ThomasVDD/SmartSupplyMini/PCB/Front.JPG

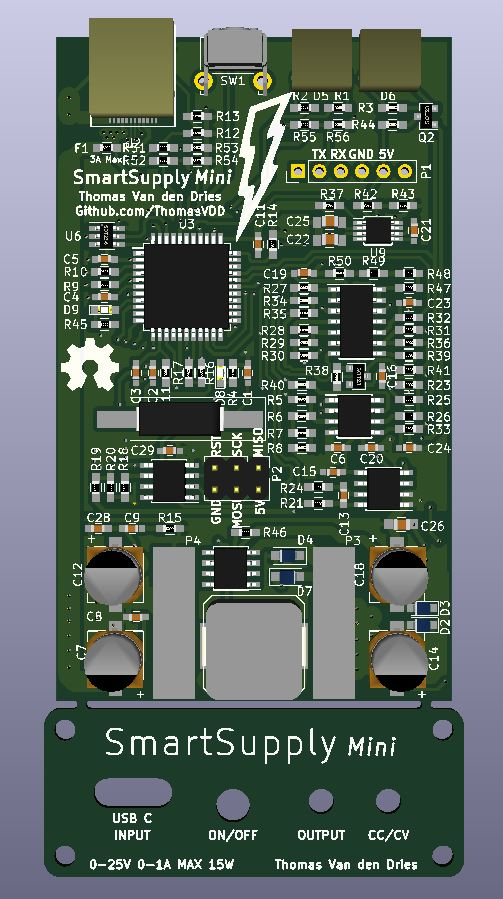
PCB/Front.JPG
