ThomasVDD/SmartSupplyMini/PCB/Back.JPG

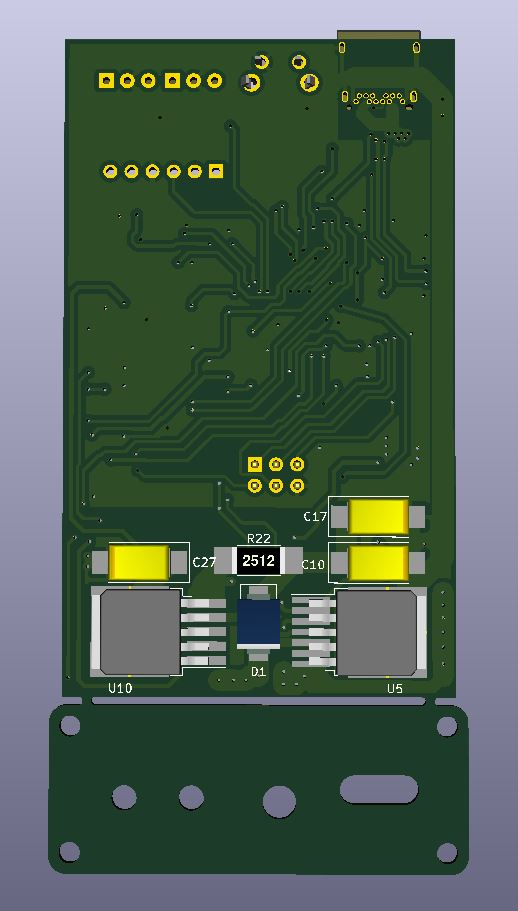
PCB/Back.JPG
