ThomasVDD/SmartSupplyMini/AndroidApp/AppImage.png

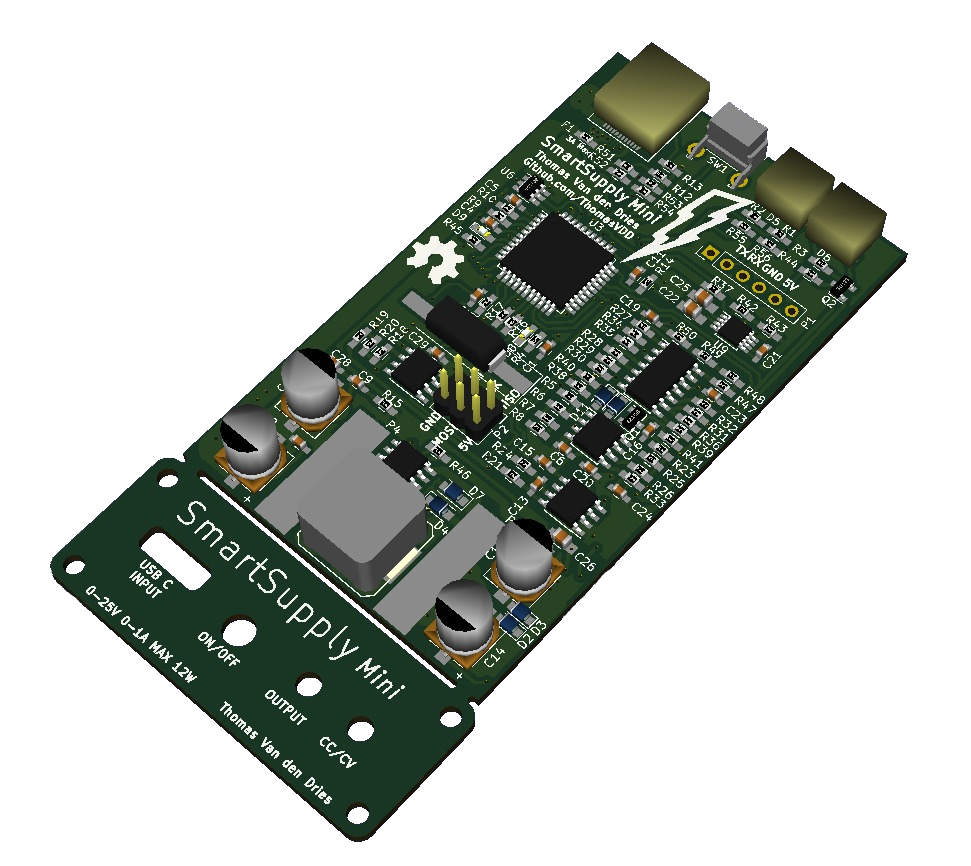
AndroidApp/AppImage.png
