ThomasVDD/SmartSupplyMini/PCB/bom.xlsx

Reference | Amount | Value | Footprint | Price/unit | Price total
Capacitors
C3, 4, 5, 6, 8, 11, 13, 15 16, 19, 20, 23, 24, 29 | 14 | 100n | Capacitors_SMD:C_0603_HandSoldering |  | 0
C22, 25, 26 | 3 | 22u | Capacitors_SMD:C_0805_HandSoldering |  | 0
C1, 2 | 2 | 22p | Capacitors_SMD:C_0603_HandSoldering |  | 0
C28 | 1 | 4.7n | Capacitors_SMD:C_0603_HandSoldering |  | 0
C9 | 1 | 47n | Capacitors_SMD:C_0603_HandSoldering |  | 0
C21 | 1 | 1u | Capacitors_SMD:C_0603_HandSoldering |  | 0
C7, 12, 14, 18 | 4 | 100u | Capacitors_SMD:CP_Elec_6.3x7.7 | 0.25 | 1 | x | http://be.farnell.com/panasonic-electronic-components/eeefk1v101xp/cap-alu-elec-100uf-35v-smd/dp/1850114
C10, 17, 27 | 3 | 22u | Capacitors_Tantalum_SMD:CP_Tantalum_Case-V_EIA-7343-20_Hand | 1.14 | 3.42 | x | http://be.farnell.com/vishay/293d226x9035d2te3/cap-tant-22uf-35v-case-d/dp/1754235
 |  |  |  |  | 0
Resistors |  |  |  |  | 0
 |  |  |  |  | 0
R11, 14, 19, 23, 25, 26, 32, 37, 38, 51, 52, 56 | 12 | 10k | Resistors_SMD:R_0603_HandSoldering |  | 0
R7, 8, 27, 28, 29, 31, 35, 43, 49, 50 | 10 | 3k 0.1% | Resistors_SMD:R_0603_HandSoldering | 0.209 | 2.09 | x | http://be.farnell.com/panasonic-electronic-components/era3aeb302v/res-thin-film-3k-0-1-0-1w-0603/dp/1670182
R5, 6, 30, 34, 36, 42, 47, 48 | 8 | 12k 0.1% | Resistors_SMD:R_0603_HandSoldering | 0.307 | 2.456 | x | http://be.farnell.com/panasonic-electronic-components/era3aeb123v/res-thin-film-12k-0-1-0-1w-0603/dp/1577620
R12, 13, 16, 17, 53, 54, 55 | 7 | 5k1 | Resistors_SMD:R_0603_HandSoldering |  | 0
R1, 2, 3, 4, 18, 44, 45 | 7 | 620R | Resistors_SMD:R_0603_HandSoldering |  | 0
R15, 33, 39, 40 | 4 | 1k | Resistors_SMD:R_0603_HandSoldering |  | 0
R21, 24 | 2 | 10R | Resistors_SMD:R_0603_HandSoldering |  | 0
R9, 10 | 2 | 22R | Resistors_SMD:R_0603_HandSoldering |  | 0
R41, 46 | 2 | 100R | Resistors_SMD:R_0603_HandSoldering |  | 0
R20 | 1 | 2.2k | Resistors_SMD:R_0603_HandSoldering |  | 0
R22 | 1 | 0R5 1W | Resistors_SMD:R_2512_HandSoldering | 1.12 | 1.12 | x | http://be.farnell.com/vishay/wslt2512r5000fea/res-metal-strip-0-5ohm-1-2512/dp/2420780
 |  |  |  |  | 0
Diodes |  |  |  |  | 0
 |  |  |  |  | 0
D5, 6 | 2 | Led_x2 | LEDs:LED_Rectangular_W5.0mm_H2.0mm-3pins | 0.335 | 0.67 | x | http://be.farnell.com/kingbright/l-130wdt-1egw/housing-led-w-1-led-red-green/dp/2001682
D8, 9 | 2 | LED | LEDs:LED_0603_HandSoldering | 0.0485 | 0.097 | x | http://be.farnell.com/kingbright/kpt-1608yc/led-0603-yellow-8mcd-588nm/dp/2099227
D2, 3, 10, 11 | 4 | 1N4148 | Diodes_SMD:D_SOD-323_HandSoldering | 0.0592 | 0.2368 | x | http://be.farnell.com/multicomp/1n4148ws/diode-h-speed-100v-0-15a-sod323/dp/1466524
D1 | 1 | SS34 | Diodes_SMD:D_SMB_Handsoldering | 0.472 | 0.472 | x | http://be.farnell.com/on-semiconductor-fairchild/ss34/diode-schottky-40v-3a-do-214/dp/1470970
D4 | 1 | SM4007PL-TP | Diodes_SMD:D_SOD-123F | 0.891 | 0.891 | x | http://be.farnell.com/micro-commercial-components/sm4007pl-tp/diode-stand-recov-1kv-sod-123fl/dp/2295709
D7 | 1 | DZ2W27000L | Diodes_SMD:D_SOD-123F | 0.555 | 0.555 | x | http://be.farnell.com/panasonic-electronic-components/dz2w27000l/diode-zener-1w-27-0v-mini2-f3/dp/2285380
 |  |  |  |  | 0
Other |  |  |  |  | 0
 |  |  |  |  | 0
F1 | 1 | FUSE 3A | Resistors_SMD:R_0603_HandSoldering | 0.26 | 0.26 | x | http://be.farnell.com/vishay/mfu0603ff03150p100/fuse-0603-smd-3-15a/dp/2057171
L1 | 1 | 47u | Inductors:SELF-WE-PD-XXL | 0.5 | 0.5
P1 | 1 | Bluetooth HM-10 | Pin_Headers:Pin_Header_Straight_1x06_Pitch2.54mm | 4 | 4
P2 | 1 | ISP | Pin_Headers:Pin_Header_Straight_2x03_Pitch2.54mm |  | 0
P3 | 1 | V+ | .pretty:BananaPad |  | 0
P4 | 1 | V- | .pretty:BananaPad |  | 0
Q1, 2 | 2 | IRLML0030TRPBF | TO_SOT_Packages_SMD:SOT-23 | 0.283 | 0.566 | x | http://be.farnell.com/infineon/irlml0030trpbf/mosfet-n-ch-30v-5-3a-sot23-3/dp/1791366
SW1 | 1 | SW_PUSH_SMALL_H | Buttons_Switches_ThroughHole:SW_Tactile_SKHH_Angled |  | 0
U1 | 1 | OPA2170 | Housings_SOIC:SOIC-8_3.9x4.9mm_Pitch1.27mm | 2.13 | 2.13 | x | http://be.farnell.com/texas-instruments/opa2170aid/op-amp-dual-36v-1-2mhz-8soic/dp/2144252
U10 | 1 | LT3080 | TO_SOT_Packages_SMD:TO-263-5_TabPin3 | 4.17 | 4.17 | x | http://be.farnell.com/linear-technology/lt3080eq-pbf/ldo-reg-0v-to-36v-1-1a-5d2pak/dp/2102649
U11 | 1 | LM334M | Housings_SOIC:SOIC-8_3.9x4.9mm_Pitch1.27mm | 0.874 | 0.874 | x | http://be.farnell.com/texas-instruments/lm334m-nopb/ic-adj-current-source-smd/dp/1469226
U2 | 1 | USB_TYPE_C | .pretty:USB_C_Connector | 1.55 | 1.55 | x | http://be.farnell.com/amphenol-commercial-products/12401548e4-2a-500/usb-connector-3-1-type-c-rcpt/dp/2564554
U3 | 1 | ATMEGA32U4RC-A | Housings_QFP:TQFP-44_10x10mm_Pitch0.8mm | 3.63 | 3.63 | x | http://be.farnell.com/microchip/atmega32u4-au/mcu-8bit-megaavr-16mhz-tqfp-44/dp/1748525
U4 | 1 | MCP41010 | Housings_SOIC:SOIC-8_3.9x4.9mm_Pitch1.27mm | 1.23 | 1.23 | x | http://be.farnell.com/microchip/mcp41010-i-sn/digital-pot-spi-10k-41010-soic8/dp/9758607
U5 | 1 | LT1370 | TO_SOT_Packages_SMD:TO-263-7_TabPin4 | 8.92 | 8.92 | x | http://be.farnell.com/linear-technology/lt1370hvir-pbf/switching-reg-500khz-6a-12v-7d2pak/dp/2252746
U6 | 1 | MAX6610 | TO_SOT_Packages_SMD:SOT-23-6_Handsoldering | 2.08 | 2.08 | x | http://be.farnell.com/maxim-integrated-products/max6610aut-t/voltage-reference-series-sot-23/dp/2729135
U7 | 1 | OPA4170 | Housings_SOIC:SOIC-14_3.9x8.7mm_Pitch1.27mm | 2.89 | 2.89 | x | http://be.farnell.com/texas-instruments/opa4170aidr/op-amp-quad-1-2mhz-0-4v-us-soic/dp/2769335
U8 | 1 | INA219 | Housings_SOIC:SOIC-8_3.9x4.9mm_Pitch1.27mm | 2.54 | 2.54 | x | http://be.farnell.com/texas-instruments/ina219bidr/current-power-monitor-11khz-soic/dp/2496402
U9 | 1 | MCP1252 | Housings_SSOP:MSOP-8_3x3mm_Pitch0.65mm | 1.27 | 1.27 | x | http://be.farnell.com/microchip/mcp1252-33x50i-ms/ic-charge-pump-120ma-smd-msop8/dp/1332064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
Y1 | 1 | 16Mhz | Crystals:Crystal_SMD_HC49-SD_HandSoldering | 0.301 | 0.301 | x | http://be.farnell.com/fox-electronics/foxsdlf-160-20/crystal-16-0mhz-20pf-smd/dp/2063983
 |  |  |  |  | 49.9188
 |  |  |  | BTW | 21%
 |  |  |  | Total | 60.401748
 |  |  |  | PCB | 36
 |  |  |  | Shipping | 18
 |  |  |  | Import | 25
 |  |  |  | Total | 79
 |  |  |  | Total | 99.901748
