ThomasVDD/SmartSupplyMini/PCB/Schematic.pdf

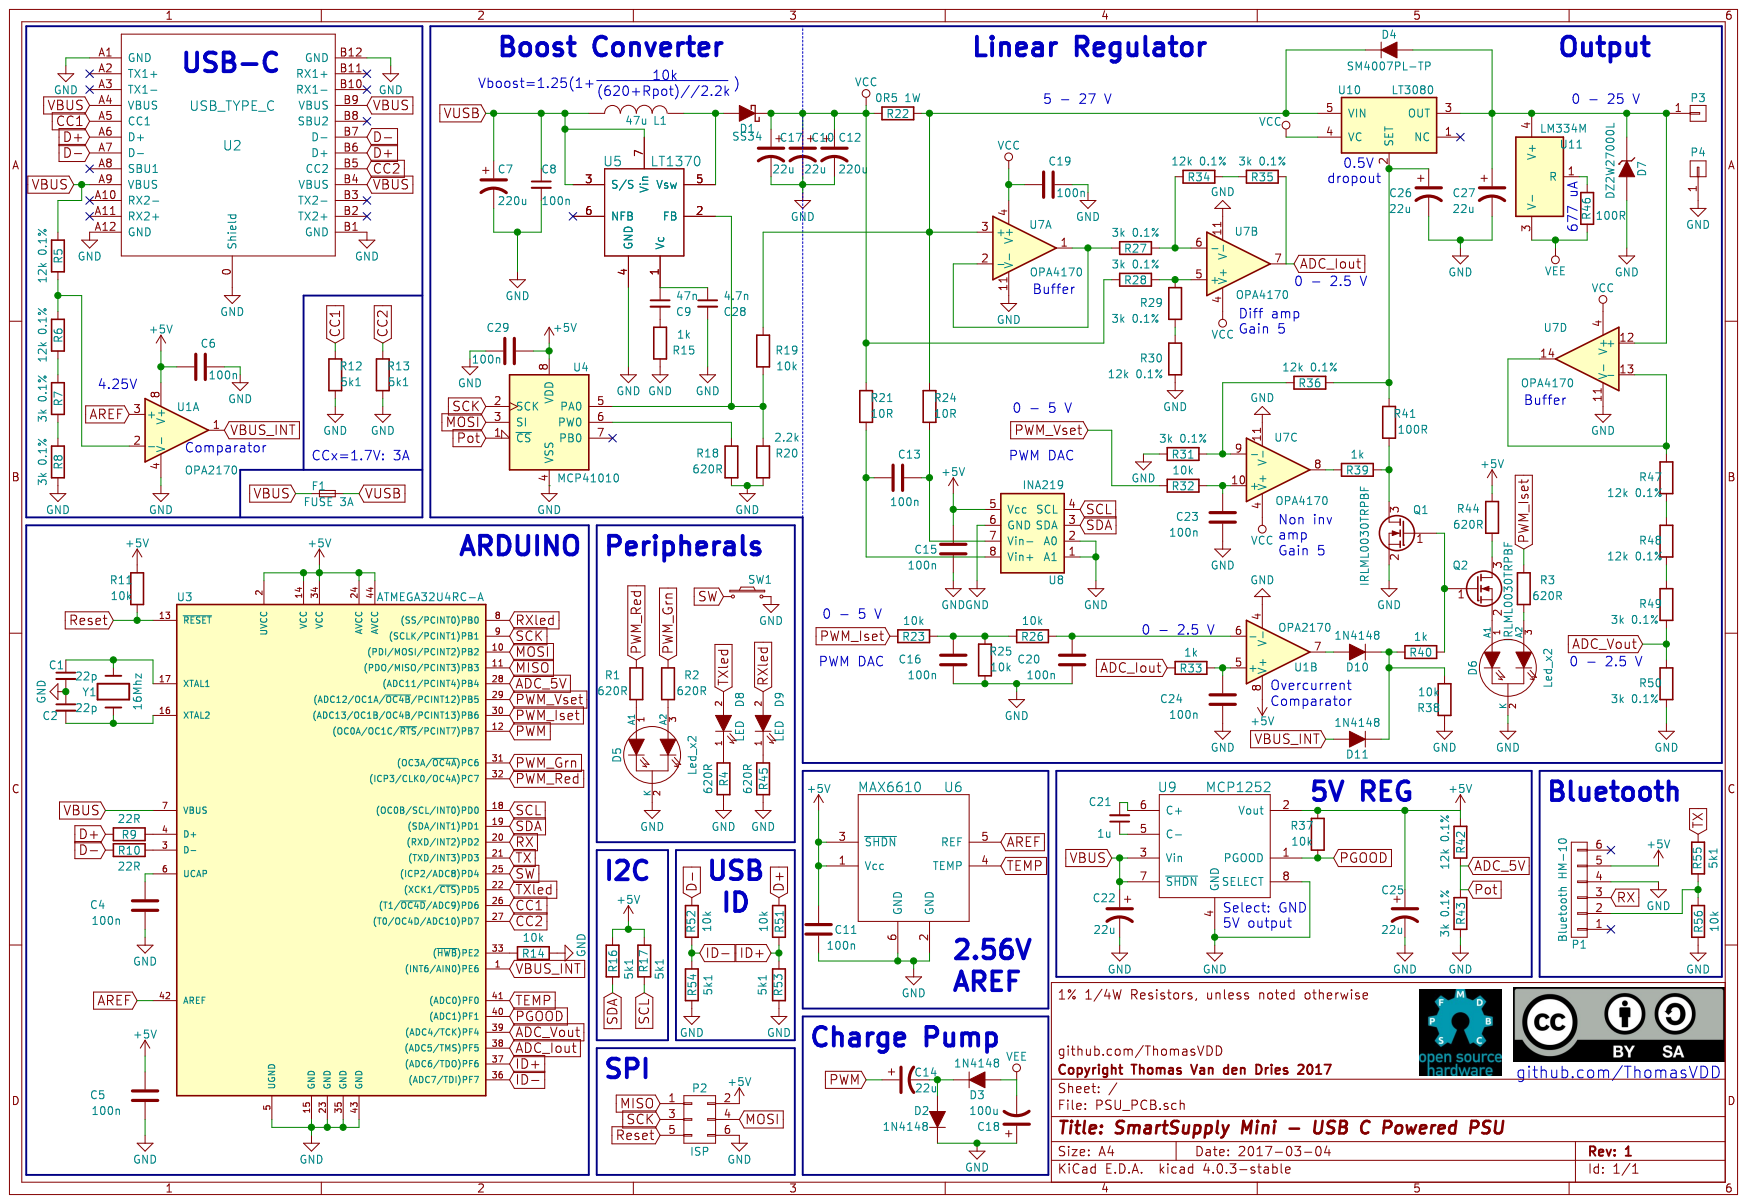
[picture p4: page 1]
