ThomasVDD/SmartSupplyMini/PCB/PCB.pdf

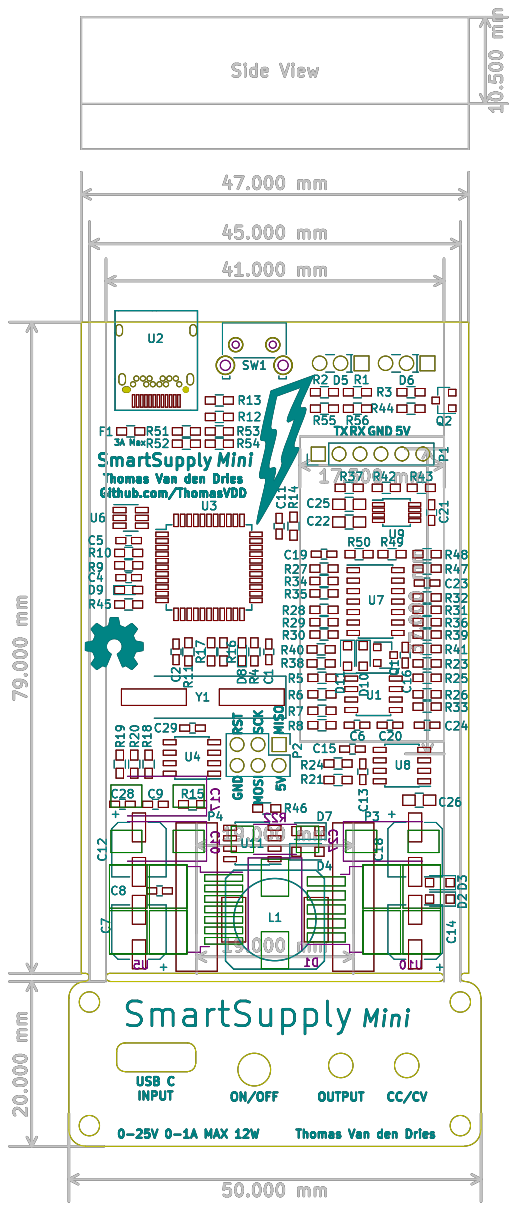
[picture p5: page 1]
