ThomasVDD/SmartSupplyMini/PCB/PSU_PCB.kicad_pcb

## KiCad design PCB/PSU_PCB.kicad_pcb (2018-08-09)

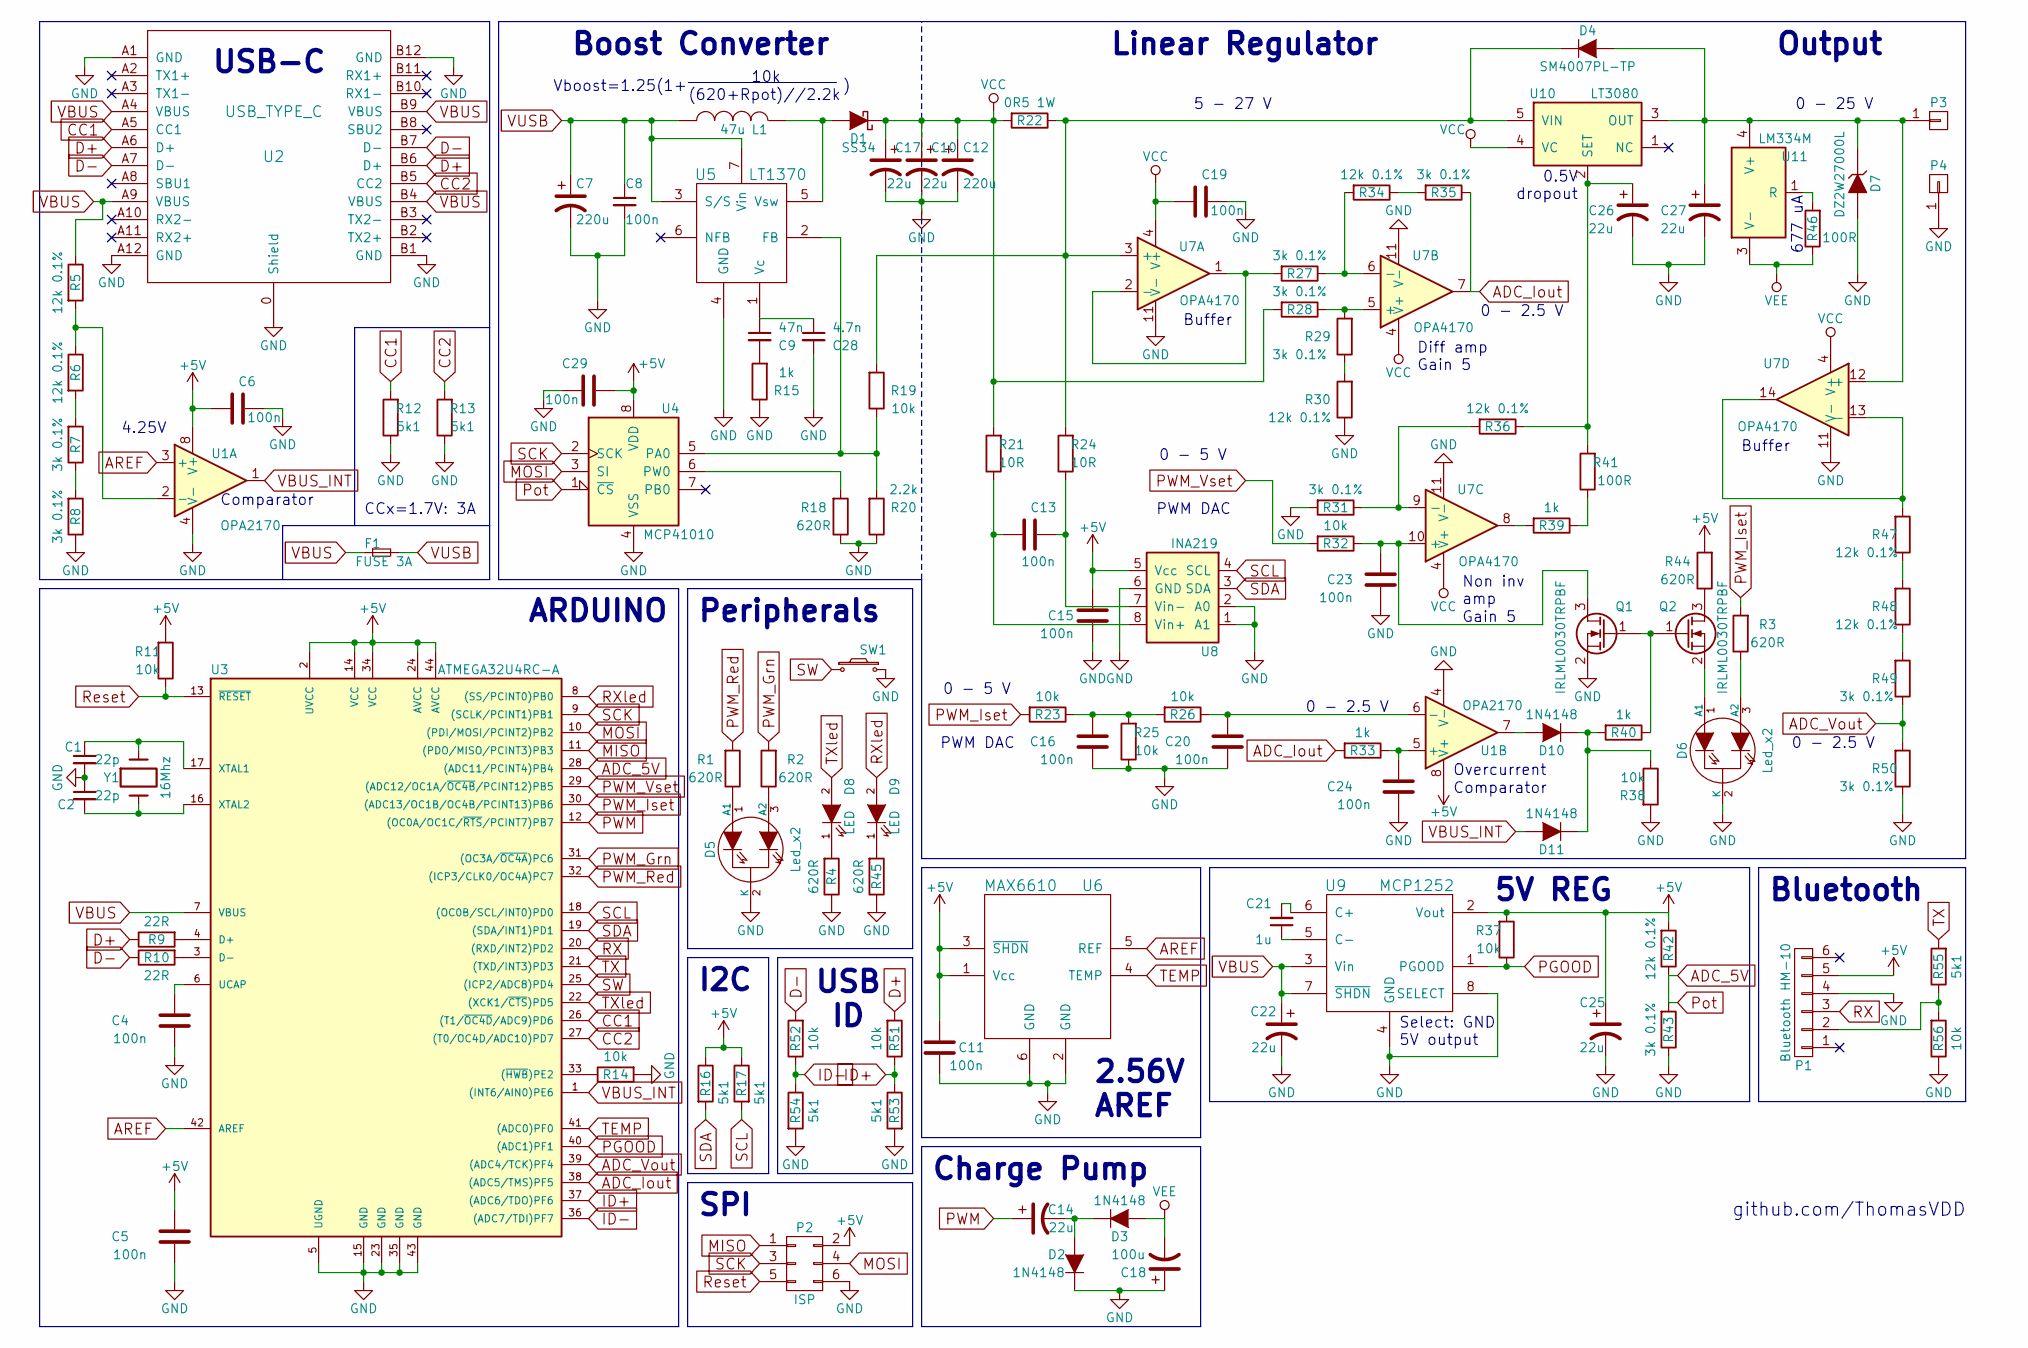
[picture p6: schematic PSU_PCB.sch, SmartSupply Mini - USB C Powered PSU]

Parts:
C1, C2: 22p; C_0603_HandSoldering
C4, C5, C6, C8, C11, C13, C15, C16, C19, C20, C23, C24, C29: 100n; C_0603_HandSoldering
C7, C12: 220u; CP_Elec_6.3x7.7
C9: 47n; C_0603_HandSoldering
C10, C17, C27: 22u; CP_Tantalum_Case-V_EIA-7343-20_Hand
C14: 22u; CP_Elec_6.3x7.7
C18: 100u; CP_Elec_6.3x7.7
C21: 1u; C_0603_HandSoldering
C22, C25, C26: 22u; C_0805_HandSoldering
C28: 4.7n; C_0603_HandSoldering
D1: SS34; D_SMC_Handsoldering
D2, D3, D10, D11: 1N4148; D_SOD-323_HandSoldering
D4: SM4007PL-TP; D_SOD-123F
D5, D6: Led_x2; LED_Rectangular_W5.0mm_H2.0mm-3pins
D7: DZ2W27000L; D_SOD-123F
D8, D9: LED; LED_0603_HandSoldering
F1: FUSE 3A; R_0603_HandSoldering
L1: 47u; SELF-WE-PD-XXL
P1: Bluetooth HM-10; Pin_Header_Straight_1x06_Pitch2.54mm
P2: ISP; Pin_Header_Straight_2x03_Pitch2.54mm
P3: V+; BananaPad
P4: V-; BananaPad
Q1, Q2: IRLML0030TRPBF; SOT-23
R1, R2, R3, R4, R18, R44, R45: 620R; R_0603_HandSoldering
R5, R6, R30, R34, R36, R42, R47, R48: 12k 0.1%; R_0603_HandSoldering
R7, R8, R27, R28, R29, R31, R35, R43, R49, R50: 3k 0.1%; R_0603_HandSoldering
R9, R10: 22R; R_0603_HandSoldering
R11, R14, R19, R23, R25, R26, R32, R37, R38, R51, R52, R56: 10k; R_0603_HandSoldering
R12, R13, R16, R17, R53, R54, R55: 5k1; R_0603_HandSoldering
R15, R33, R39, R40: 1k; R_0603_HandSoldering
R20: 2.2k; R_0603_HandSoldering
R21, R24: 10R; R_0603_HandSoldering
R22: 0R5 1W; R_2512_HandSoldering
R41, R46: 100R; R_0603_HandSoldering
SW1: SW_PUSH_SMALL_H; SW_Tactile_SKHH_Angled
U1: OPA2170; SOIC-8_3.9x4.9mm_Pitch1.27mm
U2: USB_TYPE_C; USB_C_Connector
U3: ATMEGA32U4RC-A; TQFP-44_10x10mm_Pitch0.8mm
U4: MCP41010; SOIC-8_3.9x4.9mm_Pitch1.27mm
U5: LT1370; TO-263-7_TabPin4
U6: MAX6610; SOT-23-6_Handsoldering
U7: OPA4170; SOIC-14_3.9x8.7mm_Pitch1.27mm
U8: INA219; SOIC-8_3.9x4.9mm_Pitch1.27mm
U9: MCP1252; MSOP-8_3x3mm_Pitch0.65mm
U10: LT3080; TO-263-5_TabPin3
U11: LM334M; SOIC-8_3.9x4.9mm_Pitch1.27mm
Y1: 16Mhz; Crystal_SMD_HC49-SD_HandSoldering

Connections:
+5V: C5.2, C6.2, C11.1, C15.1, C25.1, C29.2, P1.5, P2.2, R11.2, R16.1, R17.1, R37.2, R42.2, R44.2, U1.8 (V+), U3.2 (UVCC), U3.14 (VCC), U3.24 (AVCC), U3.34 (VCC), U3.44 (AVCC), U4.8 (VDD), U6.1 (Vcc), U6.3 (~SHDN), U8.5 (Vcc), U9.2 (Vout)
ADC_5V: R42.1, R43.2, U3.28 ((ADC11/PCINT4)PB4), U4.1 (~CS)
ADC_Iout: R33.2, R35.1, U3.38 ((ADC5/TMS)PF5), U7.7
ADC_Vout: R49.1, R50.2, U3.39 ((ADC4/TCK)PF4)
AREF: U1.3 (+), U3.42 (AREF), U6.5 (REF)
CC1: R12.2, U2.A5 (CC1), U3.26 ((T1/~OC4D~/ADC9)PD6)
CC2: R13.2, U2.B5 (CC2), U3.27 ((T0/OC4D/ADC10)PD7)
D+: R9.1, R51.2, U2.A6 (D+), U2.B6 (D+)
D-: R10.1, R52.2, U2.A7 (D-), U2.B7 (D-)
GND: C1.2, C2.1, C4.1, C5.1, C6.1, C7.2, C8.2, C10.2, C11.2, C12.2, C15.2, C16.1, C17.2, C18.1, C19.1, C20.1, C22.2, C23.1, C24.1, C25.2, C26.2, C27.2, C28.2, C29.1, D2.1 (K), D5.2 (K), D6.2 (K), D7.2 (A), P1.4, P2.6, P4.1, Q1.2 (S), R4.1, R8.1, R12.1, R13.1, R14.2, R15.1, R18.1, R20.1, R25.1, R30.1, R31.2, R38.2, R43.1, R45.1, R50.1, R53.2, R54.2, R56.1, SW1.2, U1.4 (V-), U2.0 (Shield), U2.A1 (GND), U2.A12 (GND), U2.B1 (GND), U2.B12 (GND), U3.5 (UGND), U3.15 (GND), U3.23 (GND), U3.35 (GND), U3.43 (GND), U4.4 (VSS), U5.4 (GND), U6.2 (GND), U6.6 (GND), U7.11 (V-), U8.1 (A1), U8.2 (A0), U8.6 (GND), U9.4 (GND), U9.8 (SELECT)
ID+: R51.1, R53.1, U3.37 ((ADC6/TDO)PF6)
ID-: R52.1, R54.1, U3.36 ((ADC7/TDI)PF7)
MISO: P2.1, U3.11 ((PDO/MISO/PCINT3)PB3)
MOSI: P2.4, U3.10 ((PDI/MOSI/PCINT2)PB2), U4.3 (SI)
unnamed: C1.1, U3.17 (XTAL1), Y1.1
unnamed: C2.2, U3.16 (XTAL2), Y1.2
unnamed: C4.2, U3.6 (UCAP)
unnamed: C9.2, R15.2
unnamed: C13.1, R24.1, U8.7 (Vin-)
unnamed: C13.2, R21.1, U8.8 (Vin+)
unnamed: C14.2, D2.2 (A), D3.1 (K)
unnamed: C16.2, R23.1, R25.2, R26.2
unnamed: C20.2, R26.1, U1.6 (-)
unnamed: C21.1, U9.5 (C-)
unnamed: C21.2, U9.6 (C+)
unnamed: C23.2, Q1.3 (D), R32.1, U7.10 (+)
unnamed: C24.2, R33.1, U1.5 (+)
unnamed: C26.1, R36.1, R41.2, U10.2 (SET)
unnamed: C27.1, D4.2 (A), D7.1 (K), P3.1, U7.12 (+), U10.3 (OUT), U11.4 (V+)
unnamed: C9.1, C28.1, U5.1 (Vc)
unnamed: D1.2 (A), L1.1, U5.5 (Vsw)
unnamed: D4.1 (K), R19.2, R22.1, R24.2, U7.3 (+), U10.5 (VIN)
unnamed: D5.1 (A1), R1.1
unnamed: D5.3 (A2), R2.1
unnamed: D6.1 (A1), Q2.2 (S)
unnamed: D6.3 (A2), R3.1
unnamed: D8.1 (K), R4.2
unnamed: D9.1 (K), R45.2
unnamed: D10.1 (K), D11.1 (K), R38.1, R40.2
unnamed: D10.2 (A), U1.7
unnamed: P1.2, R55.1, R56.2
unnamed: Q1.1 (G), Q2.1 (G), R40.1
unnamed: Q2.3 (D), R44.1
unnamed: R5.2, R6.1, U1.2 (-)
unnamed: R6.2, R7.2
unnamed: R7.1, R8.2
unnamed: R9.2, U3.4 (D+)
unnamed: R10.2, U3.3 (D-)
unnamed: R14.1, U3.33 ((~HWB~)PE2)
unnamed: R18.2, U4.6 (PW0)
unnamed: R19.1, R20.2, U4.5 (PA0), U5.2 (FB)
unnamed: R27.1, R34.2, U7.6 (-)
unnamed: R27.2, U7.1, U7.2 (-)
unnamed: R28.1, R29.2, U7.5 (+)
unnamed: R29.1, R30.2
unnamed: R31.1, R36.2, U7.9 (-)
unnamed: R34.1, R35.2
unnamed: R39.1, R41.1
unnamed: R39.2, U7.8
unnamed: R46.2, U11.1 (R)
unnamed: R47.1, R48.2
unnamed: R47.2, U7.13 (-), U7.14
unnamed: R48.1, R49.2
PGOOD: R37.1, U3.40 ((ADC1)PF1), U9.1 (PGOOD)
PWM: C14.1, U3.12 ((OC0A/OC1C/~RTS~/PCINT7)PB7)
PWM_Grn: R2.2, U3.31 ((OC3A/~OC4A~)PC6)
PWM_Iset: R3.2, R23.2, U3.30 ((ADC13/OC1B/OC4B/PCINT13)PB6)
PWM_Red: R1.2, U3.32 ((ICP3/CLK0/OC4A)PC7)
PWM_Vset: R32.2, U3.29 ((ADC12/OC1A/~OC4B~/PCINT12)PB5)
RX: P1.3, U3.20 ((RXD/INT2)PD2)
RXled: D9.2 (A), U3.8 ((SS/PCINT0)PB0)
Reset: P2.5, R11.1, U3.13 (~RESET~)
SCK: P2.3, U3.9 ((SCLK/PCINT1)PB1), U4.2 (SCK)
SCL: R17.2, U3.18 ((OC0B/SCL/INT0)PD0), U8.4 (SCL)
SDA: R16.2, U3.19 ((SDA/INT1)PD1), U8.3 (SDA)
SW: SW1.1, U3.25 ((ICP2/ADC8)PD4)
TEMP: U3.41 ((ADC0)PF0), U6.4 (TEMP)
TX: R55.2, U3.21 ((TXD/INT3)PD3)
TXled: D8.2 (A), U3.22 ((XCK1/~CTS~)PD5)
VBUS: C22.1, F1.1, R5.1, U2.A4 (VBUS), U2.A9 (VBUS), U2.B4 (VBUS), U2.B9 (VBUS), U3.7 (VBUS), U9.3 (Vin), U9.7 (~SHDN)
VBUS_INT: D11.2 (A), U1.1, U3.1 ((INT6/AIN0)PE6)
VCC: C10.1, C12.1, C17.1, C19.2, D1.1 (K), R21.2, R22.2, R28.2, U7.4 (V+), U10.4 (VC)
VEE: C18.2, D3.2 (A), R46.1, U11.3 (V-)
VUSB: C7.1, C8.1, F1.2, L1.2, U5.3 (S/S), U5.7 (Vin)

Notes on the sheet:
677 uA
Charge Pump
5V REG
0 - 5 V
0 - 2.5 V
Buffer
Diff amp Gain 5
Comparator
PWM DAC
Non inv amp
Gain 5
0 - 25 V
5 - 27 V
Boost Converter
github.com/ThomasVDD
Vboost=1.25(1+ )
10k
(620+Rpot)//2.2k
__________________
USB-C
ARDUINO
I2C
SPI
Select: GND 5V output
2.56V AREF
Linear Regulator
Output
Peripherals
4.25V
Bluetooth
USB ID
CCx=1.7V: 3A
Overcurrent
0.5V dropout

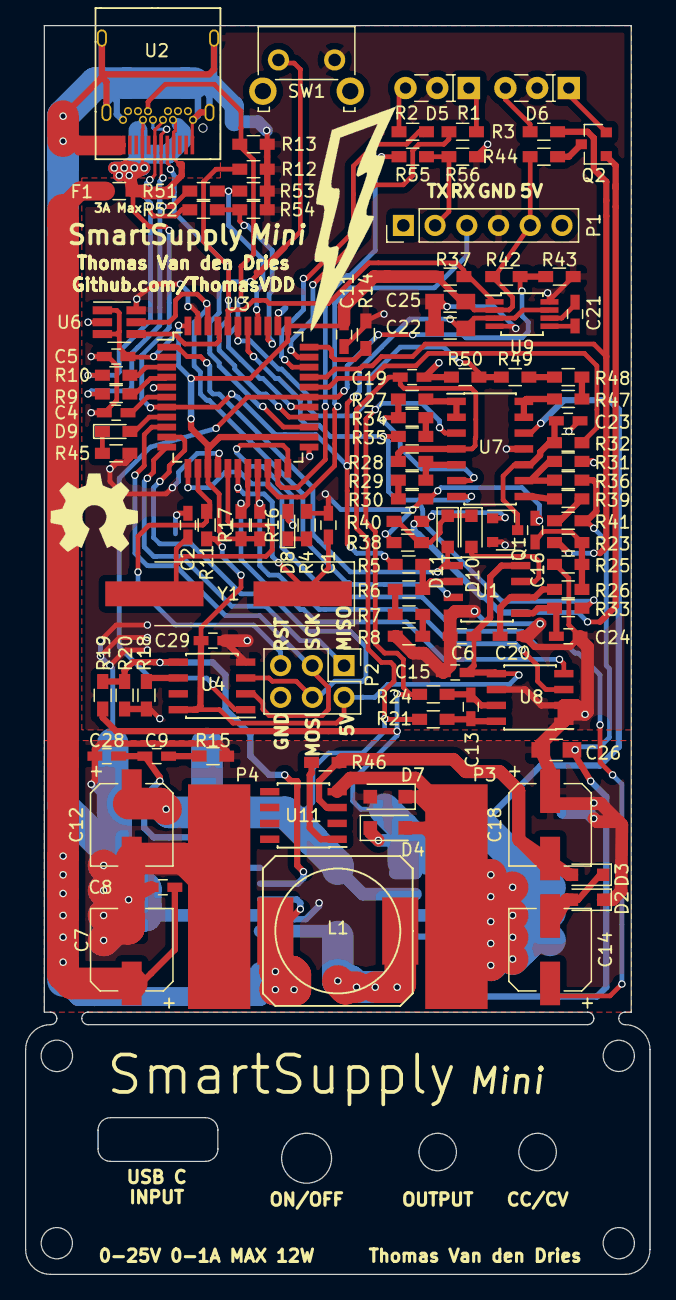
[picture p7: board PSU_PCB.kicad_pcb from above]

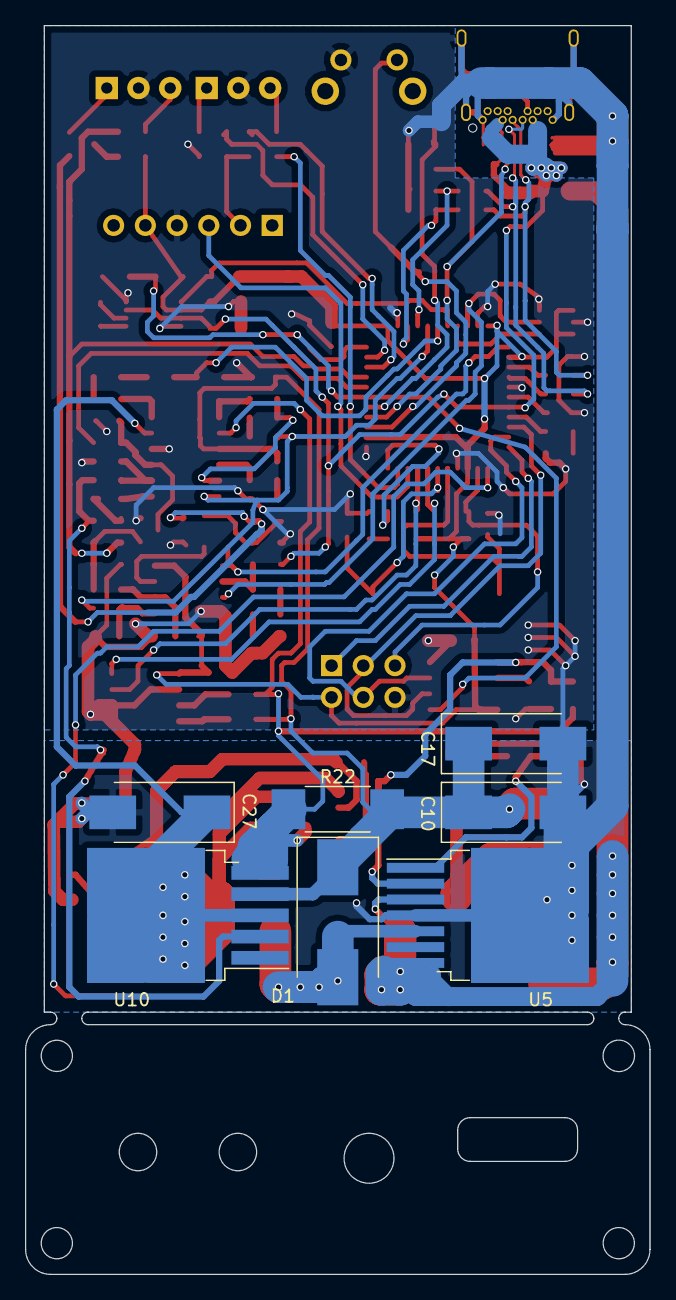
[picture p8: board PSU_PCB.kicad_pcb from below]

Board: 2 copper layers, 50.0 x 100.0 mm, 116 parts (7 on the bottom side), 84 nets.
