ThomasVDD/SmartSupplyMini/(commit log)

2018-04-27 Removed unnecessary files
    [Atmega32u4_pins.xlsx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]
2018-08-09 Fixed minor PCB error Adjusted code for current measurement
    [PSU_PCB-B.CrtYd.gbr, PSU_PCB-B.Cu.gbr, PSU_PCB-B.Mask.gbr, PSU_PCB-B.SilkS.gbr, PSU_PCB-Edge.Cuts.gbr, PSU_PCB-F.CrtYd.gbr, PSU_PCB-F.Cu.gbr, PSU_PCB-F.Mask.gbr]
