ThomasVDD/SmartSupplyMini/(notices)

Notices in the files:
PCB/PSU_PCB.sch:
Copyright Thomas Van den Dries 2017
